Zen7q/GarageGhost/hardware/GarageGhost_Wiring_EN.pdf

GARAGEGHOST - COMPLETE ESP32-S3 VOICE ASSISTANT WIRING | A0 - all connections on one sheet
MAIN ENCLOSURE - COMMON LOW-VOLTAGE SYSTEM | LOADS

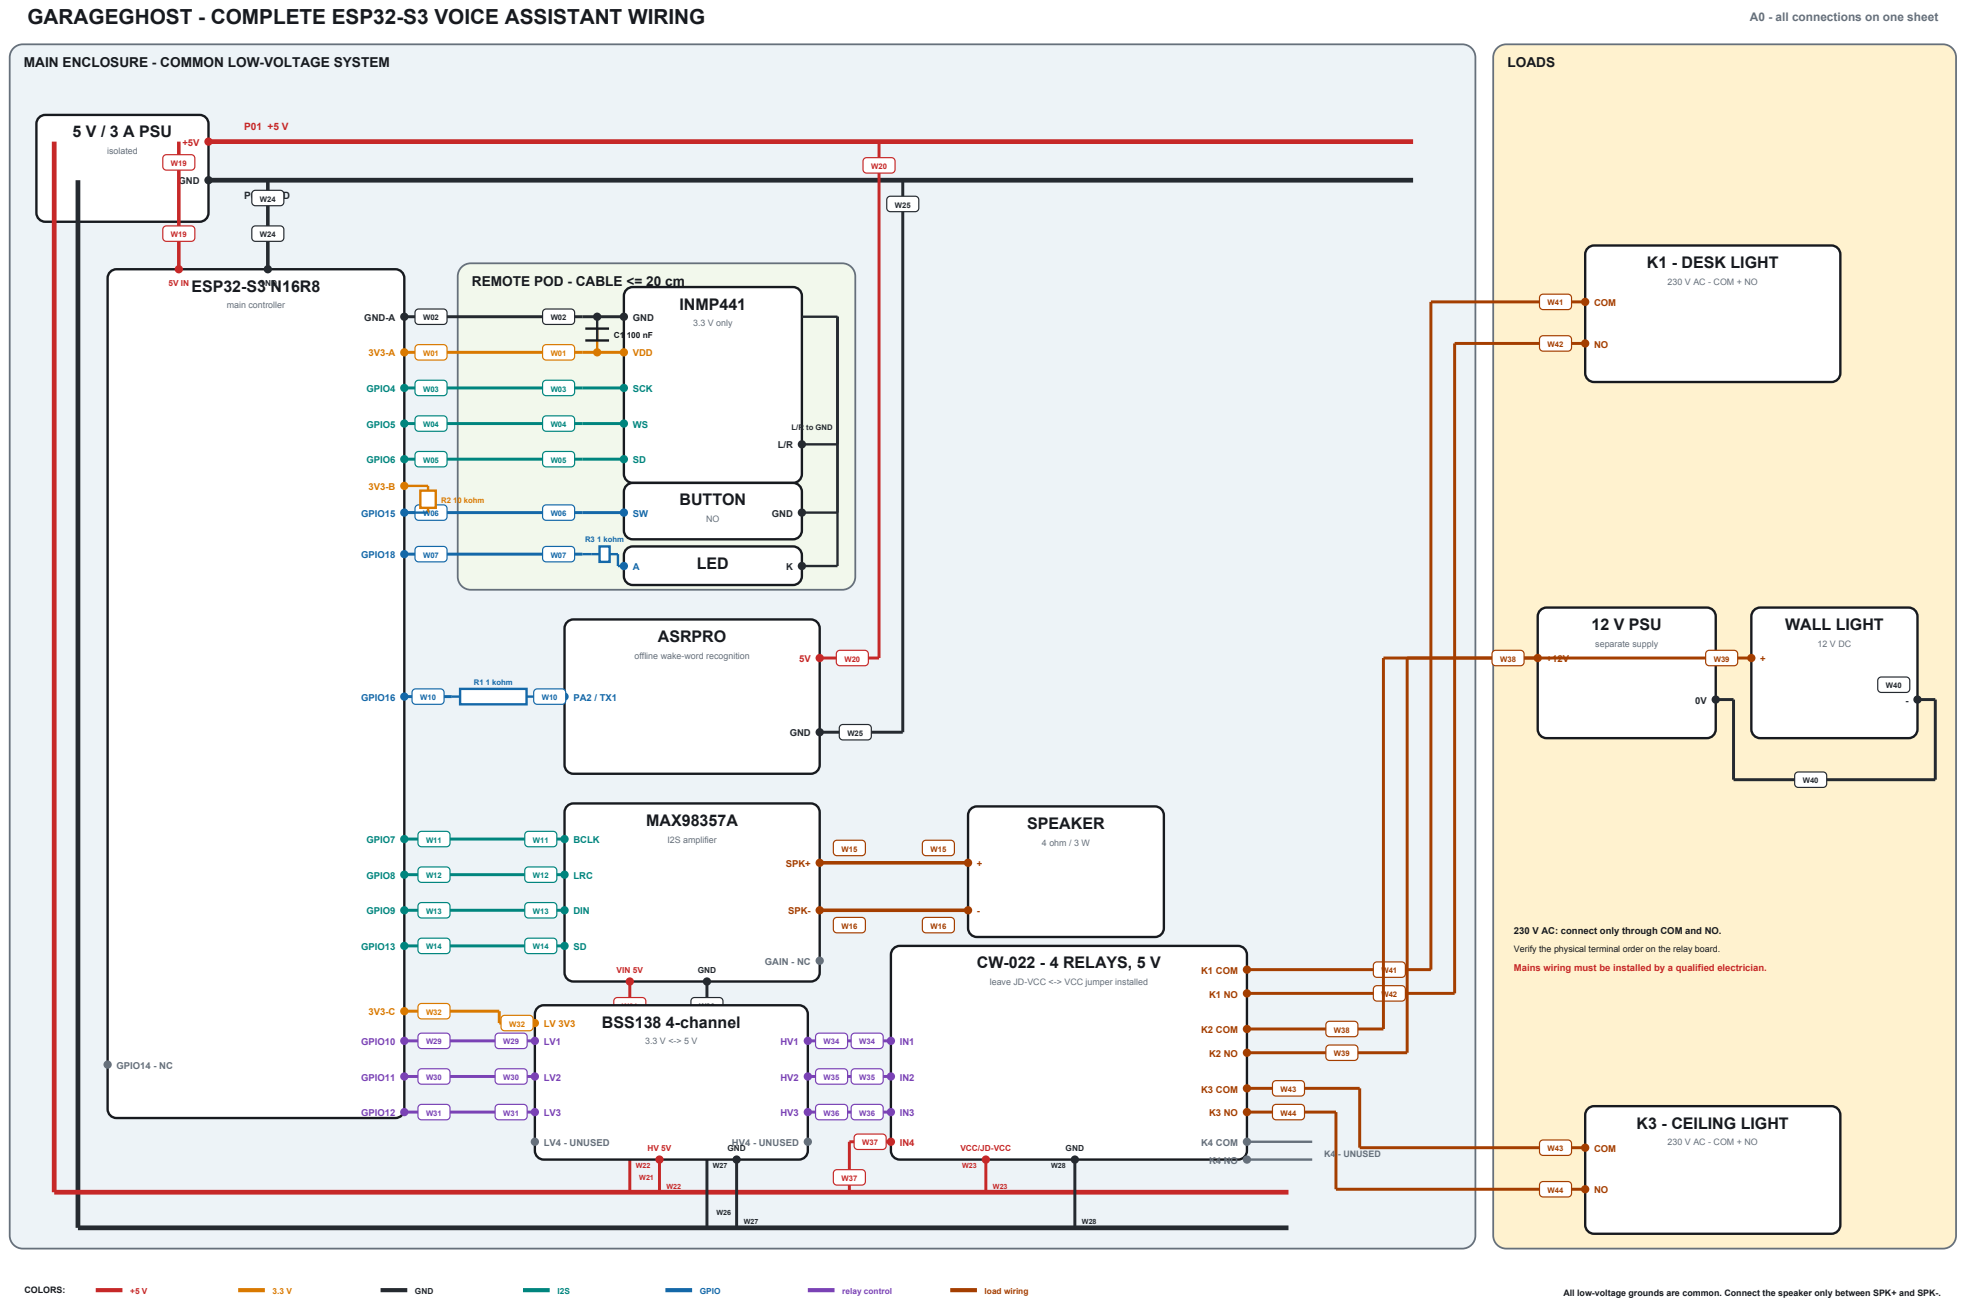
[picture p1: page 1]
5 V / 3 A PSU; isolated; GND; ESP32-S3 N16R8; main controller; GND-A; GPIO4; GPIO5; GPIO6; GPIO15; GPIO18; GPIO16; GPIO7; GPIO8; GPIO9; GPIO13; GPIO10; GPIO11; GPIO12; GPIO14 - NC; INMP441; 3.3 V only; VDD; SCK; L/R to GND; BUTTON; LED; R3 1 kohm; R2 10 kohm; ASRPRO; R1 1 kohm; MAX98357A; BCLK; I2S amplifier; LRC; DIN; VIN 5V; SPK+; SPK-; GAIN - NC; SPEAKER; 4 ohm / 3 W; BSS138 4-channel; LV4 - UNUSED; HV4 - UNUSED; CW-022 - 4 RELAYS, 5 V; VCC/JD-VCC; K1 COM; K2 COM; K3 COM; K4 COM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

REMOTE POD - CABLE <= 20 cm

230 V AC - COM + NO

offline wake-word recognition

230 V AC: connect only through COM and NO.

Verify the physical terminal order on the relay board.

Mains wiring must be installed by a qualified electrician.

leave JD-VCC <-> VCC jumper installed
