Zen7q/GarageGhost/firmware/GarageGhost/GarageGhost.ino

// GarageGhost workshop voice assistant. ESP32 Arduino core 3.3.1, ArduinoJson 7.4.2.
// Open the complete GarageGhost sketch folder in Arduino IDE.
void assistantSetup();
void assistantLoop();
void setup(){assistantSetup();}
void loop(){assistantLoop();}
