Zen7q/GarageGhost/firmware/GarageGhost/TrustAnchors.h

#pragma once
// GTS Root R1–R4: https://pki.goog/roots.pem
// Amazon Root CA 1: https://www.amazontrust.com/repository/AmazonRootCA1.pem
// Отримано через перевірений HTTPS 2026-09-12. При ротації CA оновіть цей файл.
static const char TRUST_ROOTS[] = R"PEM(
-----BEGIN CERTIFICATE-----
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
bP6MvPJwNQzcmRk13NfIRmPVNnGuV/u3gm3c
-----END CERTIFICATE-----
-----BEGIN CERTIFICATE-----
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
6WLAYv7YTVWW4tAR+kg0Eeye7QUd5MjWHYbL
-----END CERTIFICATE-----
-----BEGIN CERTIFICATE-----
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
-----END CERTIFICATE-----
-----BEGIN CERTIFICATE-----
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
-----END CERTIFICATE-----
-----BEGIN CERTIFICATE-----
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
rqXRfboQnoZsG4q5WTP468SQvvG5
-----END CERTIFICATE-----
)PEM";
